edward62740/i2ds-sentinel/(threads)

Thread 5 (2022-06-29):

Fix: PSRAM CS/LED pin conflict

edward62740, 2022-06-29:
Fixed:

- [ ] _PSRAM CS/LED pin conflict_
**Connected LED pin to unused IPC tx pin**

Closed 2022-07-07.
