edward62740/i2ds-sentinel/PCB/SENTINEL.brd

## EAGLE design PCB/SENTINEL.brd (2022-07-22)

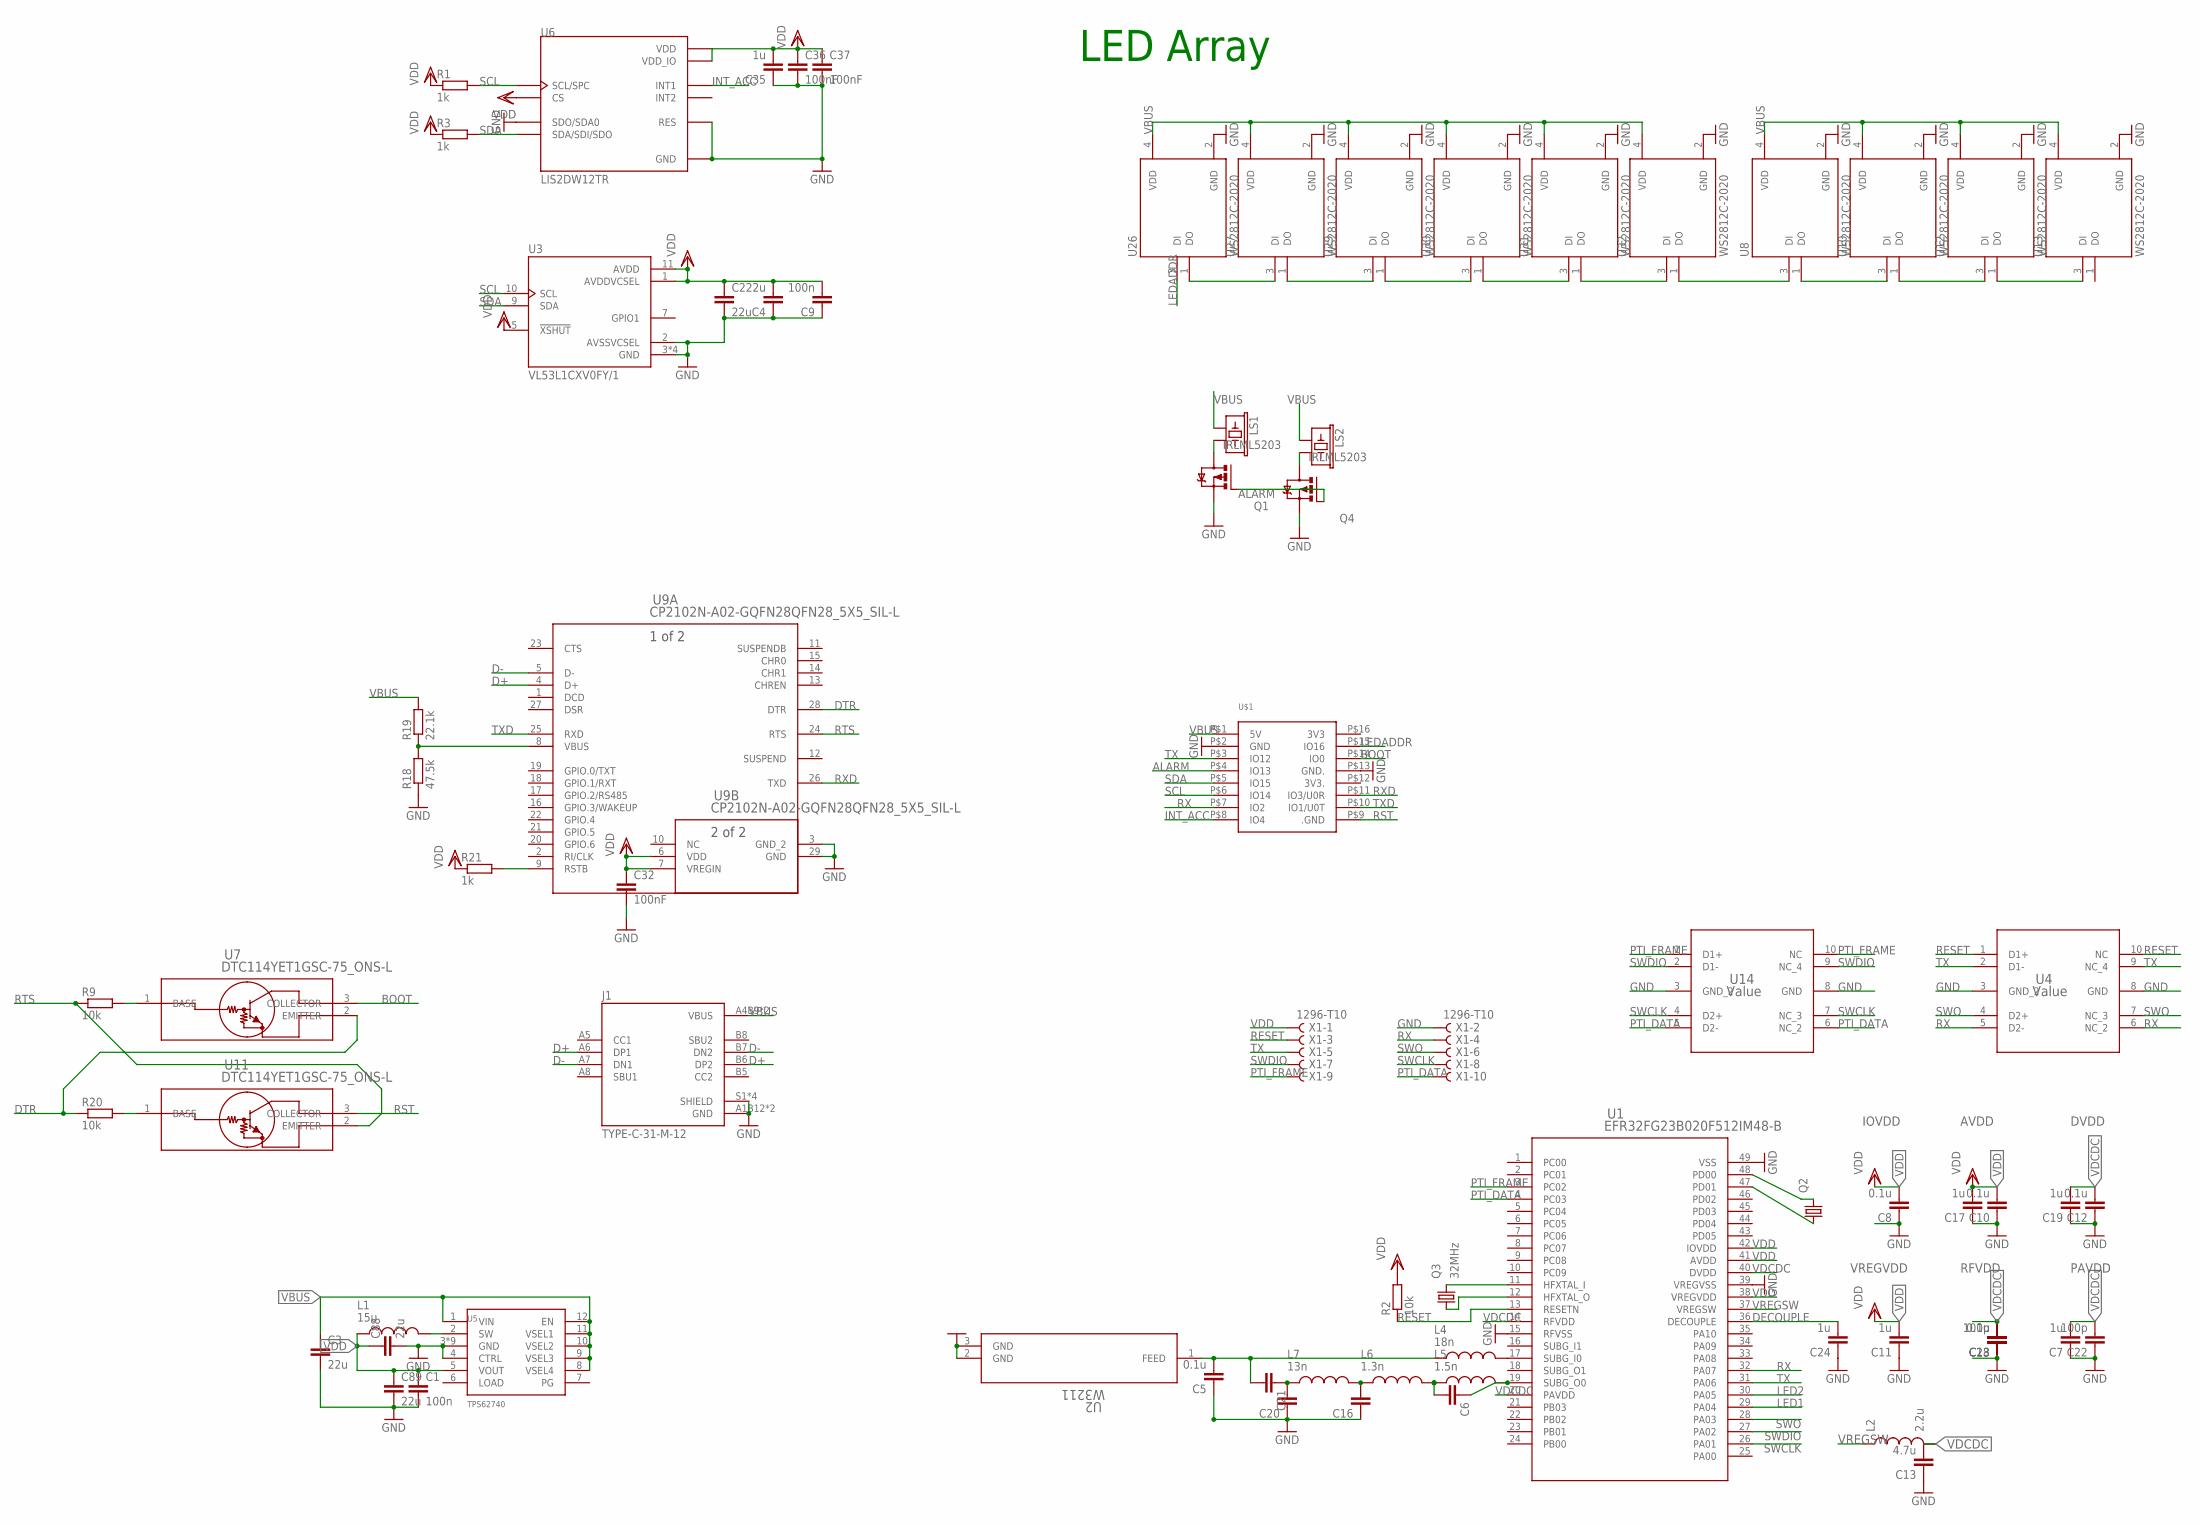
[picture p4: schematic SENTINEL.sch]

Parts:
C1, C9: 100n; C0402
C2, C3, C4, C88, C89: 22u; C0603R
C5, C8, C10, C12, C18: 0.1u; C0402
C6: 1.9p; C0402
C7, C11, C17, C19, C24: 1u; C0402
C13: 4.7u; C0603R
C16: 7.2p; C0402
C20: 1.3p; C0402
C21: 220p; C0402
C22, C23: 100p; C0402
C32, C36, C37: 100nF; C0402
C35: 1u; C0603R
J1: TYPE-C-31-M-12; HRO_TYPE-C-31-M-12
L1: 15u; INDC3225X120N
L2: 2.2u; L0603
L4: 18n; INDC0402X26N
L5: 1.5n; INDC0402X26N
L6: 1.3n; INDC0402X26N
L7: 13n; INDC0402X26N
LS1, LS2: BUZZER-PTH_KIT; BUZZER-12MM-KIT
Q1, Q4: IRLML5203; MICRO3
Q2: KX-327-RT; 2.0X1.2
Q3: 32MHz; 2.0X1.6_KX-5
R1, R3, R21: 1k; R0402
R2, R9, R20: 10k; R0402
R18: 47.5k; R0402
R19: 22.1k; R0402
U1: EFR32FG23B020F512IM48-B; QFN_48_SIL
U2: W3211; CHIP_3211_PUL
U3: VL53L1CXV0FY/1; SENSOR_VL53L1CXV0FY/1
U4, U14: Value; DQA0010A
U5: TPS62740; DSS
U6: LIS2DW12TR; LGA12R50P4X4_200X200X70
U7, U11: DTC114YET1GSC-75_ONS-L; SC-75_ONS-L
U8, U10, U12, U13, U26, U27, U29, U30, U31, U32: WS2812C-2020; LED_WS2812C-2020
U9: CP2102N-A02-GQFN28QFN28_5X5_SIL-L; QFN28_5X5_SIL-L
U$1: ESP32-CAM
X1: 1296-T10; 1296-10

Connections:
ALARM: Q1.1 (G), Q4.1 (G), U$1.P$4 (IO13)
BOOT: U7.3 (COLLECTOR), U$1.P$14 (IO0)
D+: J1.A6 (DP1), J1.B6 (DP2), U9.4 (D+)
D-: J1.A7 (DN1), J1.B7 (DN2), U9.5 (D-)
DECOUPLE: C24.2, U1.36 (DECOUPLE)
DTR: R20.1, U7.2 (EMITTER), U9.28 (DTR)
GND: C1.2, C2.2, C3.2, C4.1, C5.1, C7.1, C8.1, C9.1, C10.1, C11.1, C12.1, C13.1, C16.1, C17.1, C18.1, C19.1, C20.1, C22.1, C23.1, C24.1, C32.2, C35.1, C36.2, C37.2, C88.2, C89.2, J1.A1B12 (GND), J1.B1A12 (GND), J1.S1 (SHIELD), J1.S2 (SHIELD), J1.S3 (SHIELD), J1.S4 (SHIELD), Q1.2 (S), Q4.2 (S), R18.1, U1.15 (RFVSS), U1.39 (VREGVSS), U1.49 (VSS), U2.2 (GND), U2.3 (GND), U3.2 (AVSSVCSEL), U3.3 (GND), U3.4 (GND), U3.6 (GND), U3.12 (GND), U4.3 (GND_2), U4.8 (GND), U5.3 (GND), U5.4 (CTRL), U5.13 (GND), U5.14 (GND), U5.15 (GND), U5.16 (GND), U5.18 (GND), U5.19 (GND), U5.20 (GND), U5.P$18 (GND), U6.3 (SDO/SDA0), U6.6 (GND), U6.7 (RES), U6.8 (GND), U8.2 (GND), U9.3 (GND_2), U9.29 (GND), U10.2 (GND), U12.2 (GND), U13.2 (GND), U14.3 (GND_2), U14.8 (GND), U26.2 (GND), U27.2 (GND), U29.2 (GND), U30.2 (GND), U31.2 (GND), U32.2 (GND), U$1.P$2 (GND), U$1.P$13 (GND.), X1.2
INT_ACC: U6.12 (INT1), U$1.P$8 (IO4)
LED1: U1.29 (PA04)
LED2: U1.30 (PA05)
LEDADDR: U26.3 (DI), U$1.P$15 (IO16)
unnamed: LS1.- (2), Q1.3 (D)
unnamed: LS2.- (2), Q4.3 (D)
unnamed: U8.1 (DO), U10.3 (DI)
unnamed: U10.1 (DO), U12.3 (DI)
unnamed: C5.2, C21.2, L4.1, U2.1 (FEED)
unnamed: C6.1, L5.2, U1.19 (SUBG_O0)
unnamed: U12.1 (DO), U13.3 (DI)
unnamed: U8.3 (DI), U32.1 (DO)
unnamed: L1.2, U5.2 (SW)
unnamed: R18.2, R19.1, U9.8 (VBUS)
unnamed: R21.2, U9.9 (RSTB)
unnamed: Q3.3 (2), U1.11 (HFXTAL_I)
unnamed: Q3.1, U1.12 (HFXTAL_O)
unnamed: Q2.1, U1.47 (PD01)
unnamed: Q2.2, U1.48 (PD00)
unnamed: L4.2, U1.17 (SUBG_I0)
unnamed: C6.2, L5.1, L6.2
unnamed: C16.2, L6.1, L7.2
unnamed: C20.2, C21.1, L7.1
unnamed: R20.2, U11.1 (BASE)
unnamed: R9.2, U7.1 (BASE)
unnamed: U26.1 (DO), U27.3 (DI)
unnamed: U27.1 (DO), U29.3 (DI)
unnamed: U29.1 (DO), U30.3 (DI)
unnamed: U30.1 (DO), U31.3 (DI)
unnamed: U31.1 (DO), U32.3 (DI)
PTI_DATA: U1.4 (PC03), U14.5 (D2-), U14.6 (NC_2), X1.10
PTI_FRAME: U1.3 (PC02), U14.1 (D1+), U14.10 (NC), X1.9
RESET: R2.1, U1.13 (RESETN), U4.1 (D1+), U4.10 (NC), X1.3
RST: U11.3 (COLLECTOR), U$1.P$9 (.GND)
RTS: R9.1, U9.24 (RTS), U11.2 (EMITTER)
RX: U1.32 (PA07), U4.5 (D2-), U4.6 (NC_2), U$1.P$7 (IO2), X1.4
RXD: U9.26 (TXD), U$1.P$11 (IO3/U0R)
SCL: R1.2, U3.10 (SCL), U6.1 (SCL/SPC), U$1.P$6 (IO14)
SDA: R3.2, U3.9 (SDA), U6.4 (SDA/SDI/SDO), U$1.P$5 (IO15)
SWCLK: U1.26 (PA01), U14.4 (D2+), U14.7 (NC_3), X1.8
SWDIO: U1.27 (PA02), U14.2 (D1-), U14.9 (NC_4), X1.7
SWO: U1.28 (PA03), U4.4 (D2+), U4.7 (NC_3), X1.6
TX: U1.31 (PA06), U4.2 (D1-), U4.9 (NC_4), U$1.P$3 (IO12), X1.5
TXD: U9.25 (RXD), U$1.P$10 (IO1/U0T)
VBUS: C3.1, J1.A4B9 (VBUS), J1.B4A9 (VBUS), LS1.+ (1), LS2.+ (1), R19.2, U5.1 (VIN), U5.8 (VSEL4), U5.9 (VSEL3), U5.10 (VSEL2), U5.11 (VSEL1), U5.12 (EN), U8.4 (VDD), U10.4 (VDD), U12.4 (VDD), U13.4 (VDD), U26.4 (VDD), U27.4 (VDD), U29.4 (VDD), U30.4 (VDD), U31.4 (VDD), U32.4 (VDD), U$1.P$1 (5V)
VDCDC: C7.2, C12.2, C13.2, C18.2, C19.2, C22.2, C23.2, L2.2, U1.14 (RFVDD), U1.20 (PAVDD), U1.40 (DVDD)
VDD: C1.1, C2.1, C4.2, C8.2, C9.2, C10.2, C11.2, C17.2, C32.1, C35.2, C36.1, C37.1, C88.1, C89.1, L1.1, R1.1, R2.2, R3.1, R21.1, U1.38 (VREGVDD), U1.41 (AVDD), U1.42 (IOVDD), U3.1 (AVDDVCSEL), U3.5 (!XSHUT), U3.11 (AVDD), U5.5 (VOUT), U6.2 (CS), U6.9 (VDD), U6.10 (VDD_IO), U9.6 (VDD), U9.7 (VREGIN), X1.1
VREGSW: L2.1, U1.37 (VREGSW)

Notes on the sheet:
IOVDD
AVDD
DVDD
VREGVDD
RFVDD
PAVDD
LED Array

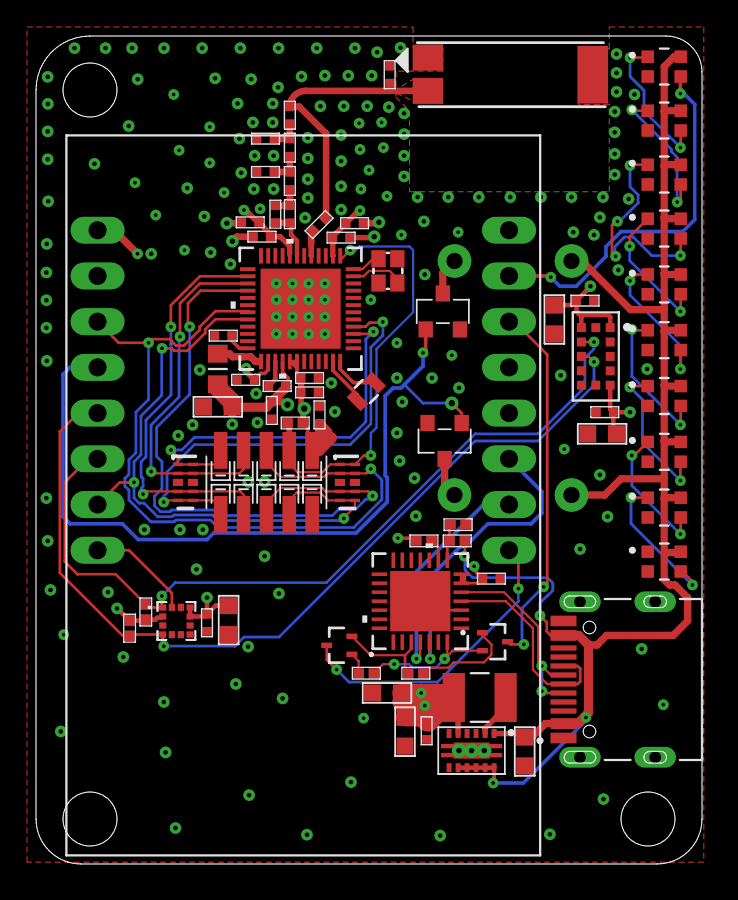
[picture p5: board SENTINEL.brd from above]

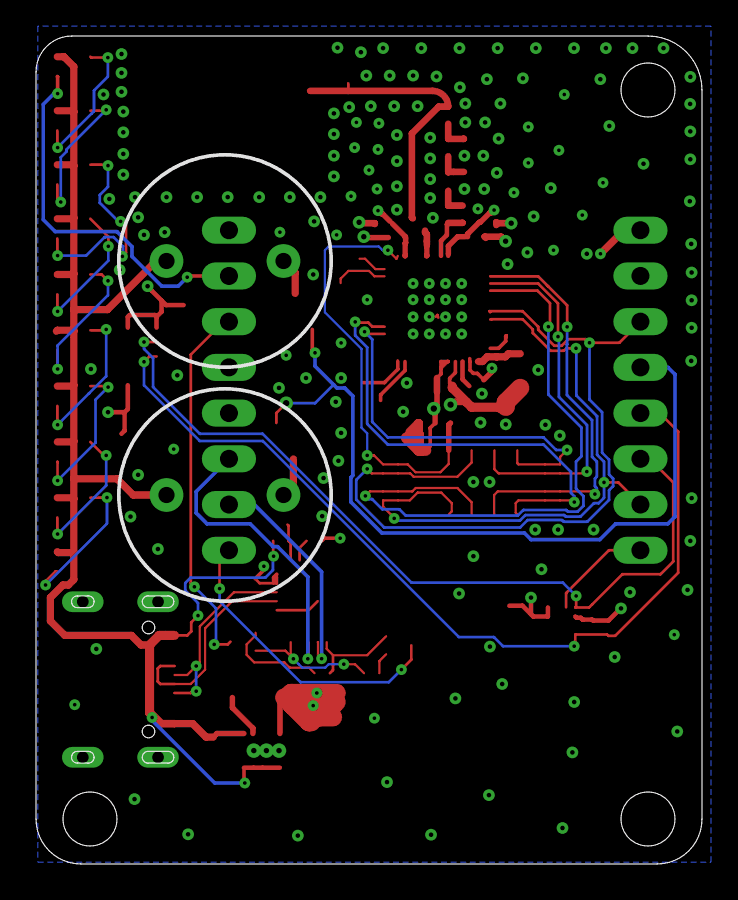
[picture p6: board SENTINEL.brd from below]

Board: 4 copper layers, 37.0 x 46.0 mm, 71 parts (2 on the bottom side), 53 nets.
