edward62740/i2ds-sentinel/SENTINEL/config/pin_config.h

#ifndef PIN_CONFIG_H
#define PIN_CONFIG_H

// $[CMU]
// [CMU]$

// $[LFXO]
// [LFXO]$

// $[PRS.ASYNCH0]
// [PRS.ASYNCH0]$

// $[PRS.ASYNCH1]
// [PRS.ASYNCH1]$

// $[PRS.ASYNCH2]
// [PRS.ASYNCH2]$

// $[PRS.ASYNCH3]
// [PRS.ASYNCH3]$

// $[PRS.ASYNCH4]
// [PRS.ASYNCH4]$

// $[PRS.ASYNCH5]
// [PRS.ASYNCH5]$

// $[PRS.ASYNCH6]
// [PRS.ASYNCH6]$

// $[PRS.ASYNCH7]
// [PRS.ASYNCH7]$

// $[PRS.ASYNCH8]
// [PRS.ASYNCH8]$

// $[PRS.ASYNCH9]
// [PRS.ASYNCH9]$

// $[PRS.ASYNCH10]
// [PRS.ASYNCH10]$

// $[PRS.ASYNCH11]
// [PRS.ASYNCH11]$

// $[PRS.SYNCH0]
// [PRS.SYNCH0]$

// $[PRS.SYNCH1]
// [PRS.SYNCH1]$

// $[PRS.SYNCH2]
// [PRS.SYNCH2]$

// $[PRS.SYNCH3]
// [PRS.SYNCH3]$

// $[GPIO]
// [GPIO]$

// $[TIMER0]
// [TIMER0]$

// $[TIMER1]
// [TIMER1]$

// $[TIMER2]
// [TIMER2]$

// $[TIMER3]
// [TIMER3]$

// $[TIMER4]
// [TIMER4]$

// $[USART0]
// [USART0]$

// $[I2C1]
// [I2C1]$

// $[EUSART1]
// EUSART1 RX on PA07
#define EUSART1_RX_PORT                          gpioPortA
#define EUSART1_RX_PIN                           7

// EUSART1 TX on PA06
#define EUSART1_TX_PORT                          gpioPortA
#define EUSART1_TX_PIN                           6

// [EUSART1]$

// $[EUSART2]
// [EUSART2]$

// $[LCD]
// [LCD]$

// $[KEYSCAN]
// [KEYSCAN]$

// $[LETIMER0]
// [LETIMER0]$

// $[ACMP0]
// [ACMP0]$

// $[ACMP1]
// [ACMP1]$

// $[VDAC0]
// [VDAC0]$

// $[PCNT0]
// [PCNT0]$

// $[LESENSE]
// [LESENSE]$

// $[HFXO0]
// [HFXO0]$

// $[I2C0]
// [I2C0]$

// $[EUSART0]
// EUSART0 RX on PA01
#define EUSART0_RX_PORT                          gpioPortA
#define EUSART0_RX_PIN                           1

// EUSART0 TX on PA00
#define EUSART0_TX_PORT                          gpioPortA
#define EUSART0_TX_PIN                           0

// [EUSART0]$

// $[PTI]
// [PTI]$

// $[MODEM]
// [MODEM]$

// $[CUSTOM_PIN_NAME]
// [CUSTOM_PIN_NAME]$

#endif // PIN_CONFIG_H
