edward62740/i2ds-sentinel/i2ds-sentinel/src/app_detector.cpp

#include <Arduino.h>
#include "app_detector.h"
#include "app_camera.h"
#include "app_common.h"

#include "person_detect_model_data.h"
#include "tensorflow/lite/micro/micro_error_reporter.h"
#include "tensorflow/lite/micro/micro_interpreter.h"
#include "tensorflow/lite/micro/micro_mutable_op_resolver.h"
#include "tensorflow/lite/schema/schema_generated.h"

tflite::ErrorReporter *error_reporter = nullptr;
const tflite::Model *model = nullptr;
tflite::MicroInterpreter *interpreter = nullptr;
TfLiteTensor *input = nullptr;

// An area of memory to use for input, output, and intermediate arrays.
constexpr int kTensorArenaSize = 81 * 1024;
static uint8_t *tensor_arena;

/*! AppDetector()
   @brief constructor
   @note
   @param *ctx pointer to detector context
*/
AppDetector::AppDetector(detector_ctx_t *ctx)
{
    this->ctx = ctx;
    this->ctx->send = xSemaphoreCreateBinary();
    this->ctx->frame = xQueueCreate(1, sizeof(uint8_t *));
}

/*! ~AppDetector()
   @brief destructor
   @note
   @param void
*/
AppDetector::~AppDetector() {}

/*! startDetectorTask()
   @brief called from outside the class to start the detector task
   @note
   @param handle task handle to be given to detector
*/
void AppDetector::startDetectorTask(TaskHandle_t handle)
{
    xTaskCreatePinnedToCore(this->startDetectorTaskImpl, "detector", 8192, this, 1, &handle, 1);
    this->task = &handle;
}

/*! startDetectorTaskImpl()
   @brief internally called task to run the detector
   @note
   @param *_this pointer to this class
*/
void AppDetector::startDetectorTaskImpl(void *_this)
{
    static_cast<AppDetector *>(_this)->detectorTask();
}

/*! detectorTask()
   @brief task to run person detection when frame pointer is sent over ctx frame queue. should be starved of ctx->send to yield cpu1.
   @note
   @param void
*/
void AppDetector::detectorTask()
{
    // Set up logging. Google style is to avoid globals or statics because of
    // lifetime uncertainty, but since this has a trivial destructor it's okay.
    // NOLINTNEXTLINE(runtime-global-variables)
    static tflite::MicroErrorReporter micro_error_reporter;
    error_reporter = &micro_error_reporter;

    // Map the model into a usable data structure. This doesn't involve any
    // copying or parsing, it's a very lightweight operation.
    model = tflite::GetModel(g_person_detect_model_data);
    if (model->version() != TFLITE_SCHEMA_VERSION)
    {
        APP_LOG_ERR("tflite version error");
    }

    if (tensor_arena == NULL)
    {
        tensor_arena = (uint8_t *)heap_caps_malloc(kTensorArenaSize, MALLOC_CAP_SPIRAM | MALLOC_CAP_8BIT);
    }
    if (tensor_arena == NULL)
    {
        APP_LOG_ERR("arena malloc failed");
    }

    static tflite::MicroMutableOpResolver<5> micro_op_resolver;
    micro_op_resolver.AddAveragePool2D();
    micro_op_resolver.AddConv2D();
    micro_op_resolver.AddDepthwiseConv2D();
    micro_op_resolver.AddReshape();
    micro_op_resolver.AddSoftmax();

    // Build an interpreter to run the model with.
    // NOLINTNEXTLINE(runtime-global-variables)
    static tflite::MicroInterpreter static_interpreter(
        model, micro_op_resolver, tensor_arena, kTensorArenaSize, error_reporter);
    interpreter = &static_interpreter;

    // Allocate memory from the tensor_arena for the model's tensors.
    TfLiteStatus allocate_status = interpreter->AllocateTensors();
    if (allocate_status != kTfLiteOk)
    {
        APP_LOG_ERR("allocate tensors failed");
    }

    // Get information about the memory area to use for the model's input.
    input = interpreter->input(0);

    xSemaphoreGive(ctx->send);

    while (1)
    {
        if (uxQueueMessagesWaiting(ctx->frame) > 0)
        {
            uint8_t *frameBuf;
            if (xQueueReceive(ctx->frame, &frameBuf, 1) == pdPASS)
            {

                // crop to 96 x 96 and xor with 0x80 to pass to model input of size int8
                for (int i = 0; i < imageWidth * imageHeight; i++)
                {
                    input->data.int8[i] = ((uint8_t *)frameBuf)[i] ^ 0x80;
                }

                // run model --- LONG RUNNING OPERATION ---
                (!interpreter->Invoke()) ? ctx->result.success = true : ctx->result.success = false;

                TfLiteTensor *output = interpreter->output(0);

                float person_score_f = ((int8_t)output->data.uint8[1] - output->params.zero_point) * output->params.scale;
                float no_person_score_f = ((int8_t)output->data.uint8[0] - output->params.zero_point) * output->params.scale;

                ctx->result.posConfidence = person_score_f * 100;
                ctx->result.negConfidence = no_person_score_f * 100;
                ctx->result.detected = ((ctx->result.posConfidence > ctx->result.negConfidence) && (ctx->result.posConfidence > DETECTOR_POS_THRESHOLD)) ? true : false;

                xSemaphoreGive(ctx->send);
            }
        }
        vTaskDelay(1); // prevent watchdog trigger
        vPortYield();
    }
}
