edward62740/i2ds-sentinel/SENTINEL/autogen/sl_component_catalog.h

#ifndef SL_COMPONENT_CATALOG_H
#define SL_COMPONENT_CATALOG_H

// APIs present in project
#define SL_CATALOG_APP_ASSERT_PRESENT
#define SL_CATALOG_APP_LOG_PRESENT
#define SL_CATALOG_CONNECT_AES_SECURITY_PRESENT
#define SL_CATALOG_CONNECT_APP_FRAMEWORK_COMMON_PRESENT
#define SL_CATALOG_CONNECT_CMSIS_STACK_IPC_PRESENT
#define SL_CATALOG_CONNECT_DEBUG_PRINT_PRESENT
#define SL_CATALOG_CONNECT_FREQUENCY_HOPPING_PRESENT
#define SL_CATALOG_CONNECT_MAC_QUEUE_PRESENT
#define SL_CATALOG_CONNECT_PARENT_SUPPORT_PRESENT
#define SL_CATALOG_CONNECT_POLL_PRESENT
#define SL_CATALOG_CONNECT_STACK_COMMON_PRESENT
#define SL_CATALOG_CONNECT_STACK_COUNTERS_PRESENT
#define SL_CATALOG_DEVICE_INIT_NVIC_PRESENT
#define SL_CATALOG_EMLIB_CORE_DEBUG_CONFIG_PRESENT
#define SL_CATALOG_IOSTREAM_EUSART_PRESENT
#define SL_CATALOG_RETARGET_STDIO_PRESENT
#define SL_CATALOG_IOSTREAM_UART_COMMON_PRESENT
#define SL_CATALOG_IOSTREAM_USART_PRESENT
#define SL_CATALOG_LEGACY_HAL_PRESENT
#define SL_CATALOG_KERNEL_PRESENT
#define SL_CATALOG_MICRIUMOS_KERNEL_PRESENT
#define SL_CATALOG_MPU_PRESENT
#define SL_CATALOG_NVM3_PRESENT
#define SL_CATALOG_POWER_MANAGER_PRESENT
#define SL_CATALOG_PRINTF_PRESENT
#define SL_CATALOG_RADIO_CONFIG_SIMPLE_CONNECT_SINGLEPHY_PRESENT
#define SL_CATALOG_RAIL_LIB_PRESENT
#define SL_CATALOG_SE_MANAGER_PRESENT
#define SL_CATALOG_COMMS_PRESENT
#define SL_CATALOG_SIMPLE_LED_PRESENT
#define SL_CATALOG_SIMPLE_LED_COMMS_PRESENT
#define SL_CATALOG_STAT_PRESENT
#define SL_CATALOG_SIMPLE_LED_STAT_PRESENT
#define SL_CATALOG_SL_SENSOR_SINK_CORE_PRESENT
#define SL_CATALOG_SLEEPTIMER_PRESENT
#define SL_CATALOG_TOKEN_MANAGER_PRESENT
#define SL_CATALOG_TOKEN_MANAGER_NVM3_PRESENT

#endif // SL_COMPONENT_CATALOG_H
