edward62740/i2ds-sentinel/SENTINEL/autogen/sl_iostream_handles.c

#include "sl_iostream.h"
#include "sl_iostream_handles.h"
#include "string.h"

const sl_iostream_instance_info_t *sl_iostream_instances_info[] = {

    &sl_iostream_instance_inst0_info,
  
};

const uint32_t sl_iostream_instances_count = sizeof(sl_iostream_instances_info) / sizeof(sl_iostream_instances_info[0]);

/***************************************************************************//**
 * Get iostream instance handle for a given name
 *
 * @return  Instance handle if it exist, NULL otherwise.
 ******************************************************************************/
sl_iostream_t *sl_iostream_get_handle(char *name)
{
  for (uint32_t i = 0; i < sl_iostream_instances_count; i++) {
    if (strcmp(sl_iostream_instances_info[i]->name, name) == 0) {
      return sl_iostream_instances_info[i]->handle;
    }
  }

  return NULL;
}
