edward62740/i2ds-sentinel/SENTINEL/autogen/sl_iostream_init_eusart_instances.h

#ifndef SL_IOSTREAM_INIT_EUSART_INSTANCES_H
#define SL_IOSTREAM_INIT_EUSART_INSTANCES_H

#include "sl_iostream.h"
#include "sl_iostream_uart.h"
#ifdef __cplusplus
extern "C" {
#endif


extern sl_iostream_t *sl_iostream_inst0_handle;
extern sl_iostream_uart_t *sl_iostream_uart_inst0_handle;
extern sl_iostream_instance_info_t sl_iostream_instance_inst0_info;


// Initialize only iostream eusart instance(s)
void sl_iostream_eusart_init_instances(void);

#if defined(SL_CATALOG_POWER_MANAGER_PRESENT)

sl_power_manager_on_isr_exit_t sl_iostream_eusart_inst0_sleep_on_isr_exit(void);

#endif

#ifdef __cplusplus
}
#endif

#endif // SL_IOSTREAM_INIT_EUSART_INSTANCES_H
