edward62740/i2ds-sentinel/(commit log)

2022-06-09 fixed camera issues
2022-07-22 Updated file structure, added PCB files
    [SENTINEL.brd, SENTINEL.sch]
