edward62740/i2ds-sentinel/(notices)

Notices in the files:
parts and their libraries:
crystal-geyer_V1_0: Copyright: Geyer-Electronic
W3211: COPYRIGHT: Copyright (C) 2022 Ultra Librarian. All rights reserved.
CP2102N: COPYRIGHT: Copyright (C) 2018 Accelerated Designs. All rights reserved
